sipeed/sipeed_keyboard/software/smk_manager/README.md

# WIP
1. OLED键帽显示和键盘宏
2. 支持切换风格
# 已完成
* 内置流水灯切换
* 视频播放模式
* 自定义流水灯
* 键盘状态显示
* 自动初始化
# 注意
首次使用会弹出认证页面，按照窗口指示操作就行。
