sipeed/sipeed_keyboard/assets/SMK68_2.png

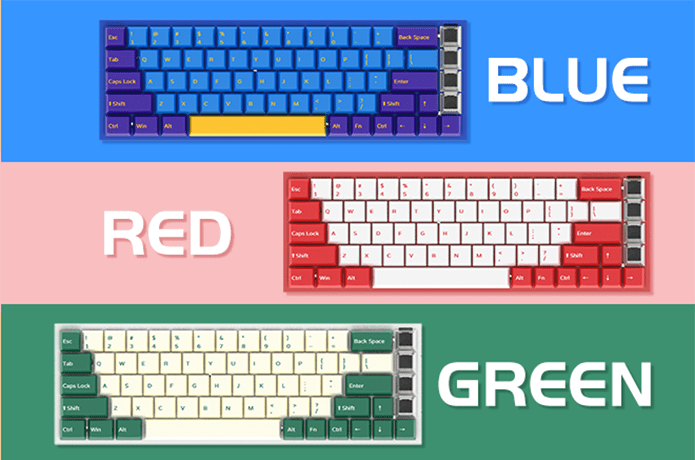
assets/SMK68_2.png
