sipeed/sipeed_keyboard/hardware/Sipeed_KeyBoard_SCH_5800.pdf

5

4

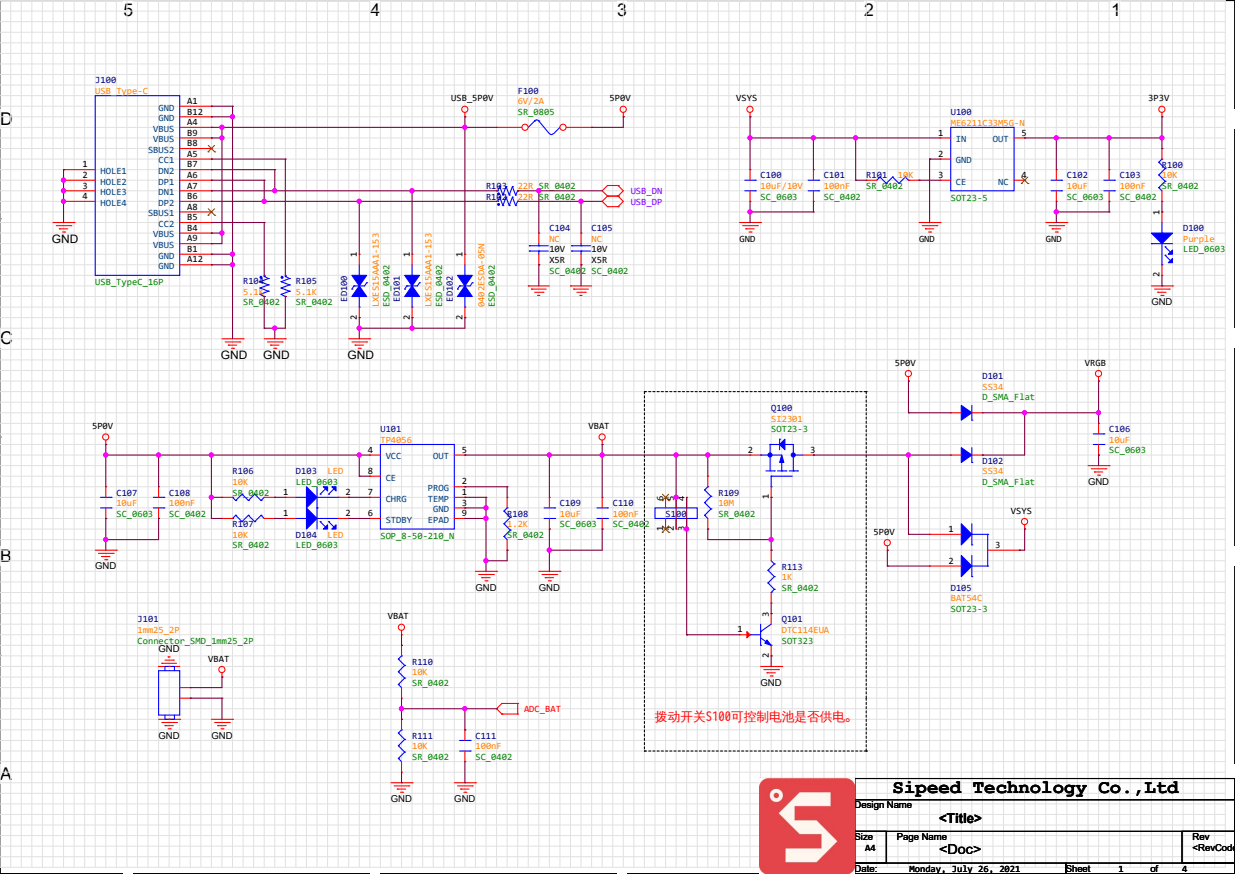
[picture p4: page 1]

J100 USB_Type-C
LXES15AAA1-153 ESD_0402 | SR_0402 ED101
SR_0402 ED102 | 0402ESDA-05N ESD_0402

GND | A1 | USB_5P0V | | | | | | 5P0V | | VSYS | | | | | | | | | | | | | | 3P3V
GND | B12 | | | SR_0805 | | | | | | | | | | | | | | U100 ME6211C33M5G-N
VBUS | | A4
VBUS | | B9 | | | | | | | | | | | | | | | | 1 | IN | OUT | 5
SBUS2 | | B8
CC1 | A5 | | | | | | | | | | | | | | | | 2

2 | HOLE2 | | DP1 | A6 | | | | | | | | | | | C100 10uF/10V | C101 100nF | R101 | 10K | | 3 | SOT23-5 GND CE | NC | 4 | | C102 10uF | C103 100nF
1 | HOLE1 | | DN2 | B7 | | | | | | | | | | | | | | | | | | | | | | | | | R100 10K

3 | HOLE3 | | DN1 | A7 | | R103 | 22R | SR_0402 | | | | USB_DN | | | | | SR_0402 | | | | | | | | | | | | SR_0402
4 | HOLE4 | | DP2 | B6 | | R102 | 22R | SR_0402 | | | | USB_DP | | | SC_0603 | SC_0402 | | | | | | | | | SC_0603 | SC_0402

SBUS1 | | A8
VBUS | | B4 | | | | | C104 NC | C105 NC | | | | | | | | | | | | | | | | | | | | LED_0603 ¹ 2 D100 Purple
CC2 | B5

GND | | | VBUS | | A9 | | | | | | | | | | | | | | | GND | | | | | GND

GND | A12 | | | | | SC_0402 X5R | SC_0402 X5R | | | | GND | | | | | | | | | | | | | | GND
GND | B1 | | | | | 10V | 10V

GND | GND | GND

5P0V | | VRGB

D_SMA_Flat

5P0V GND | | | R106 10K | D103 | LED | | 8

LED_0603 1 | | 2 | | | PROG | | 2 | | GND | | VBAT GND | | | | | | D_SMA_Flat | | GND

U101 TP4056 | | | | | | | | C106 10uF
4 | VCC | OUT | 5 | 2 3 | | | | | SC_0603

D102 SS34
SOT23-3 1 2

C107 10uF | C108 100nF | SR_0402 | | | | 7 | SOP_8-50-210_N CE CHRG | TEMP | | 1 | | | | | | | R109 10M

GND | 3 | | | C109 10uF | | C110 100nF

SC_0603 | SC_0402 | | | | | 6 | STDBY | EPAD | | 9 | R108 1.2K | | | | | S100 1 | | | | | VSYS

R107 10K | LED_0603 1 | | 2 | | | | | | | | SC_0603 | | SC_0402

D104 | LED | | | | | | | | | | | | | | 5P0V

SR_0402 | D105 BAT54C

J101 1mm25_2P | | | | | | Q101 DTC114EUA

SOT323 1

Connector_SMD_1mm25_2P
GND
VBAT GND | GND | SR_0402 | GND

ADC_BAT

拨动开关S100可控制电池是否供电。

Sipeed Sipeed Sipeed | | | | Technology Technology Technology | Co.,Ltd Co.,Ltd Co.,Ltd
Monday, July 26, 2021 | <Title> | | | 1 1 | 4 Design Name

Design Name

Size | | | Page Name | | | | | | | Rev
A4

D D

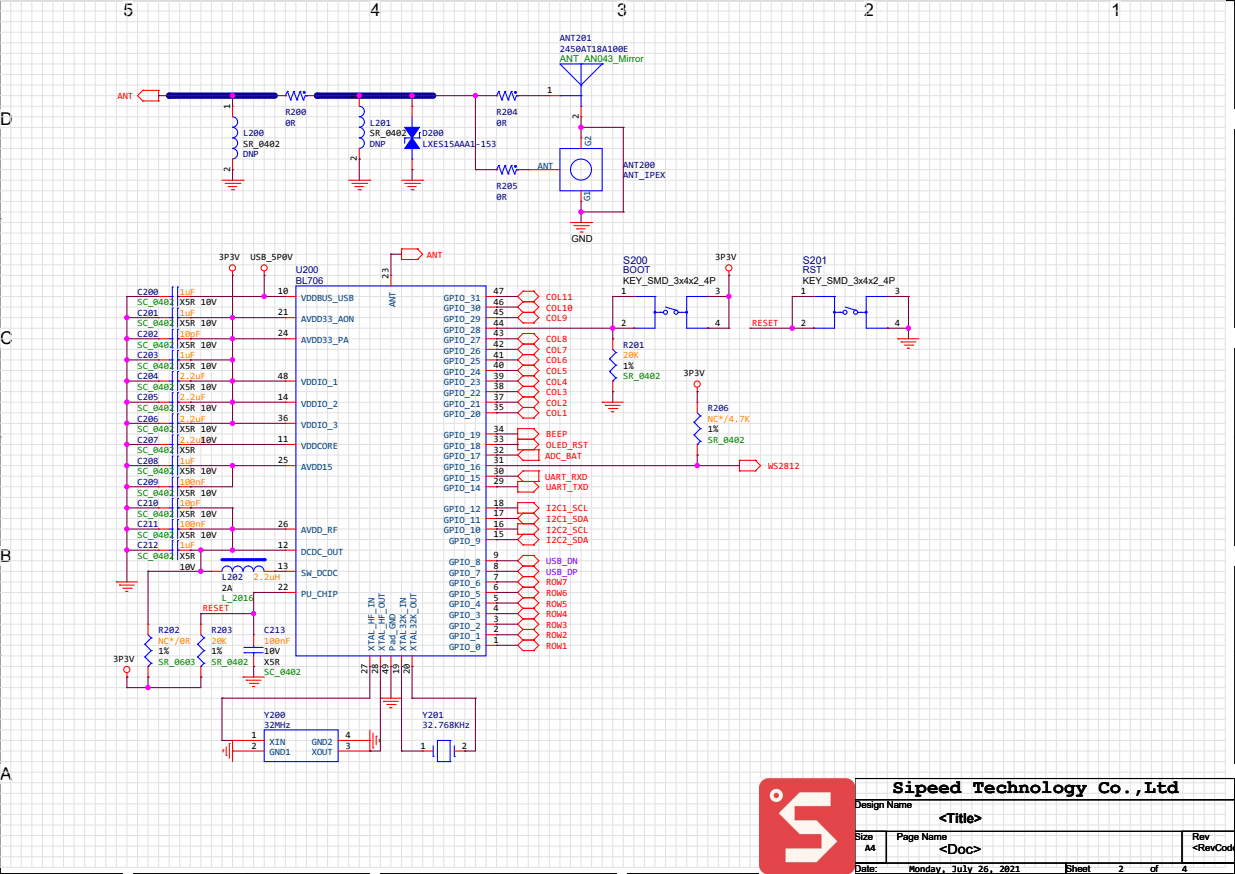
[picture p5: page 2]

2450AT18A100E ANT_AN043_Mirror 1

ANT

R200 | | | R204
0R | L201 | | 0R

L200 | | SR_0402 | D200
DNP | | | | | ANT | | G1 G2
SR_0402 | | DNP | LXES15AAA1-153

ANT200
ANT_IPEX

R205
0R

GND

3P3V | USB_5P0V | | | | | | | | S200 | | 3P3V | | | S201

C200 | | 1uF | | | | | | | | 24 ANT 23 10 | VDDBUS_USB | GPIO_31 | 47 | COL11 | 1 | | 3 | | | 1 | 3

U200 | | | | BOOT | | | | | RST
BL706 | | | | KEY_SMD_3x4x2_4P | | | | | KEY_SMD_3x4x2_4P

SC_0402 | | X5R | | 10V | | | | | | | | GPIO_30 | 46 | COL10
C201 | | 1uF | | | | | | | | | AVDD33_AON | GPIO_29 | 45 | COL9
SC_0402 | | X5R | | 10V | | | | | | | | GPIO_28 | 44 | | 2 | | 4 | RESET | | 2 | 4
C202 | | 10pF | | | | | | | | | AVDD33_PA | GPIO_27 | 43 | COL8
SC_0402 | | X5R | | 10V | | | | | | | | GPIO_26 | 42 | COL7 | R201
C203 | | 1uF | | | | | | | | | | GPIO_25 | 41 | COL6 | 20K
SC_0402 | | X5R | | 10V | | | | | | | | GPIO_24 | 40 | COL5 | 1%
C204 | | 2.2uF | | | | | | | | 48 | VDDIO_1 | GPIO_23 | 39 | COL4 | SR_0402 | 3P3V
SC_0402 | | X5R | | 10V | | | | | | | | GPIO_22 | 38 | COL3
C205 | | 2.2uF | | | | | | | | 14 | VDDIO_2 | GPIO_21 | 37 | COL2
SC_0402 | | X5R | | 10V | | | | | | | | | 35 | COL1 | | | R206
C206 | | 2.2uF | | | | | | | | 36 GPIO_20 | VDDIO_3 | | | | | | NC*/4.7K

SC_0402 | | X5R | | 10V | | | | | | 21 XTAL32K_OUT 20 XTAL32K_IN 19 | | GPIO_19 | 34 | BEEP | | | 1%

C207 | | 2.2uF | | 10V | | | | | | 11 | VDDCORE | GPIO_18 | 33 | OLED_RST | | | SR_0402
SC_0402 | | X5R | | | | | | | | | | GPIO_17 | 32 | ADC_BAT
C208 | | 1uF | | | | | | | | 25 | AVDD15 | GPIO_16 | 31 | | | | | | WS2812
SC_0402 | | X5R | | 10V | | | | | | | | GPIO_15 | 30 | UART_RXD
C212 | | 1uF | | | | | | | | 12 | DCDC_OUT | | 29 XTAL_HF_OUT 28 XTAL_HF_IN 27
C209 | | 100nF | | | | | | | | | | GPIO_14 | | UART_TXD
SC_0402 | | X5R | | 10V
C210 | | 10pF | | | | | | | | | | GPIO_12 | 18 | I2C1_SCL
SC_0402 | | X5R | | 10V | | | | | | | | GPIO_11 | 17 | I2C1_SDA
C211 | | 100nF | | | | | | | | 26 | AVDD_RF | GPIO_10 | 16 | I2C2_SCL
SC_0402 | | X5R | | 10V | | | | | | | | GPIO_9 | 15 | I2C2_SDA

SC_0402 | | X5R | | | | | | | | | | GPIO_8 | 9 | USB_DN

10V | | | | | | | 13 | SW_DCDC | GPIO_7 | 8 | USB_DP

L202 | | 2.2uH | | | | GPIO_6 | 7 | ROW7
2A | | | | 22 | PU_CHIP | GPIO_5 | 6 | ROW6
L_2016 | | | | | | GPIO_4 | 5 | ROW5
RESET | | | | | | | | GPIO_3 | 4 | ROW4

R202 | | | | R203 | | | | C213 | | | GPIO_1 | 1 Pad_GND 49 2 | ROW2

GPIO_2 | 3 | ROW3

NC*/0R | | | | 20K | | | | 100nF | | | GPIO_0 | | ROW1
1% | | | | 1% | | | | 10V

Y200 | | | Y201
32MHz | | | 32.768KHz
1 | XIN | GND2 | 4
2 | GND1 | XOUT | 3 | 1 2

D D

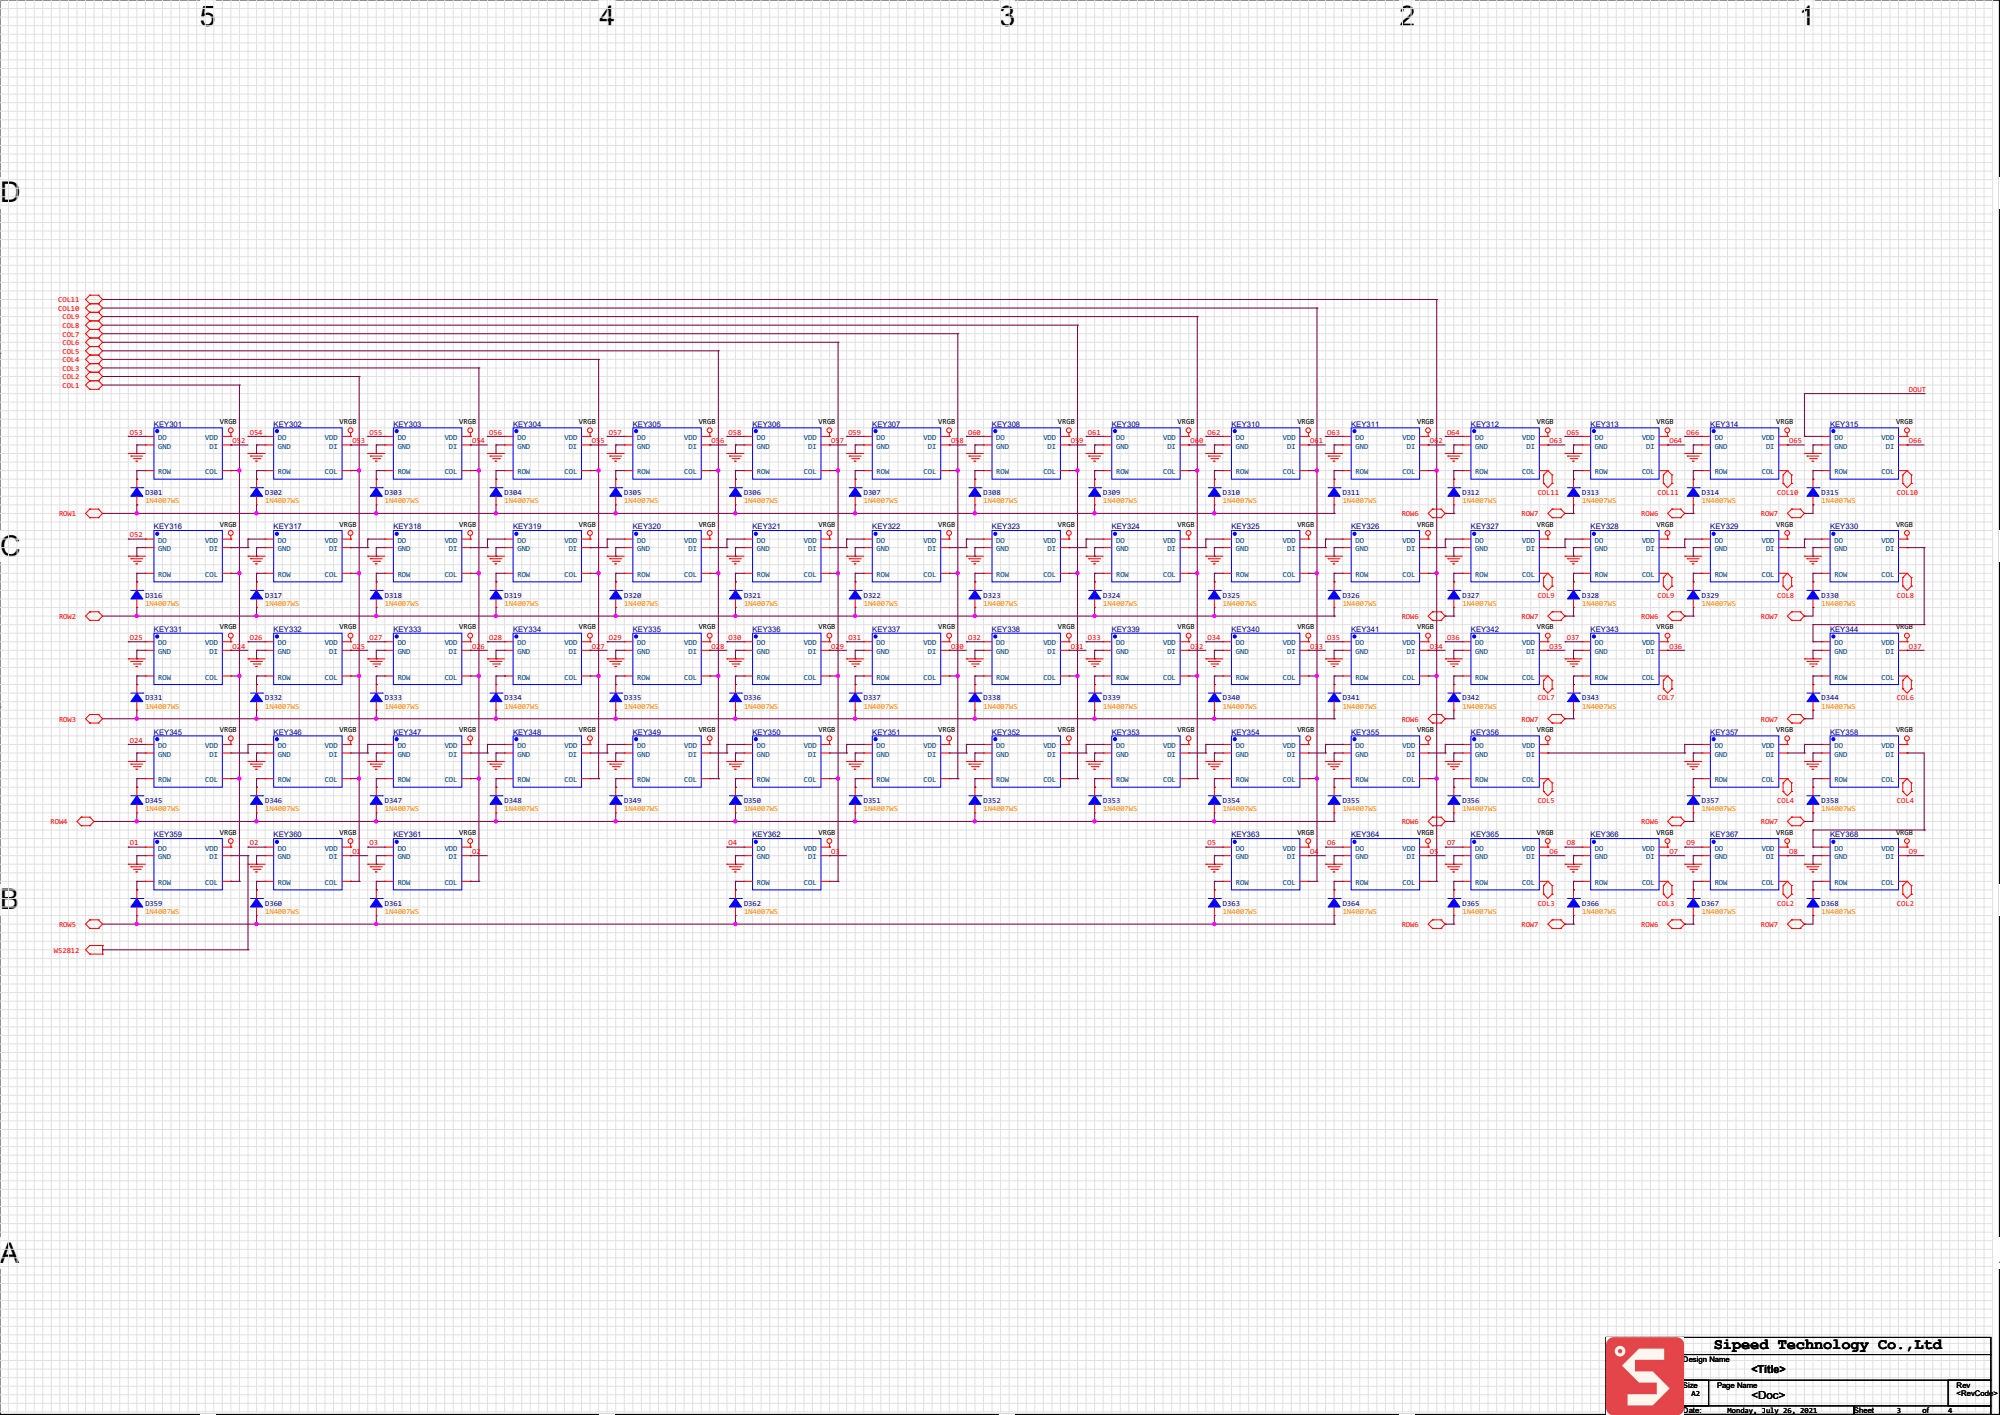
[picture p6: page 3]

D D

# 蜂鸣器

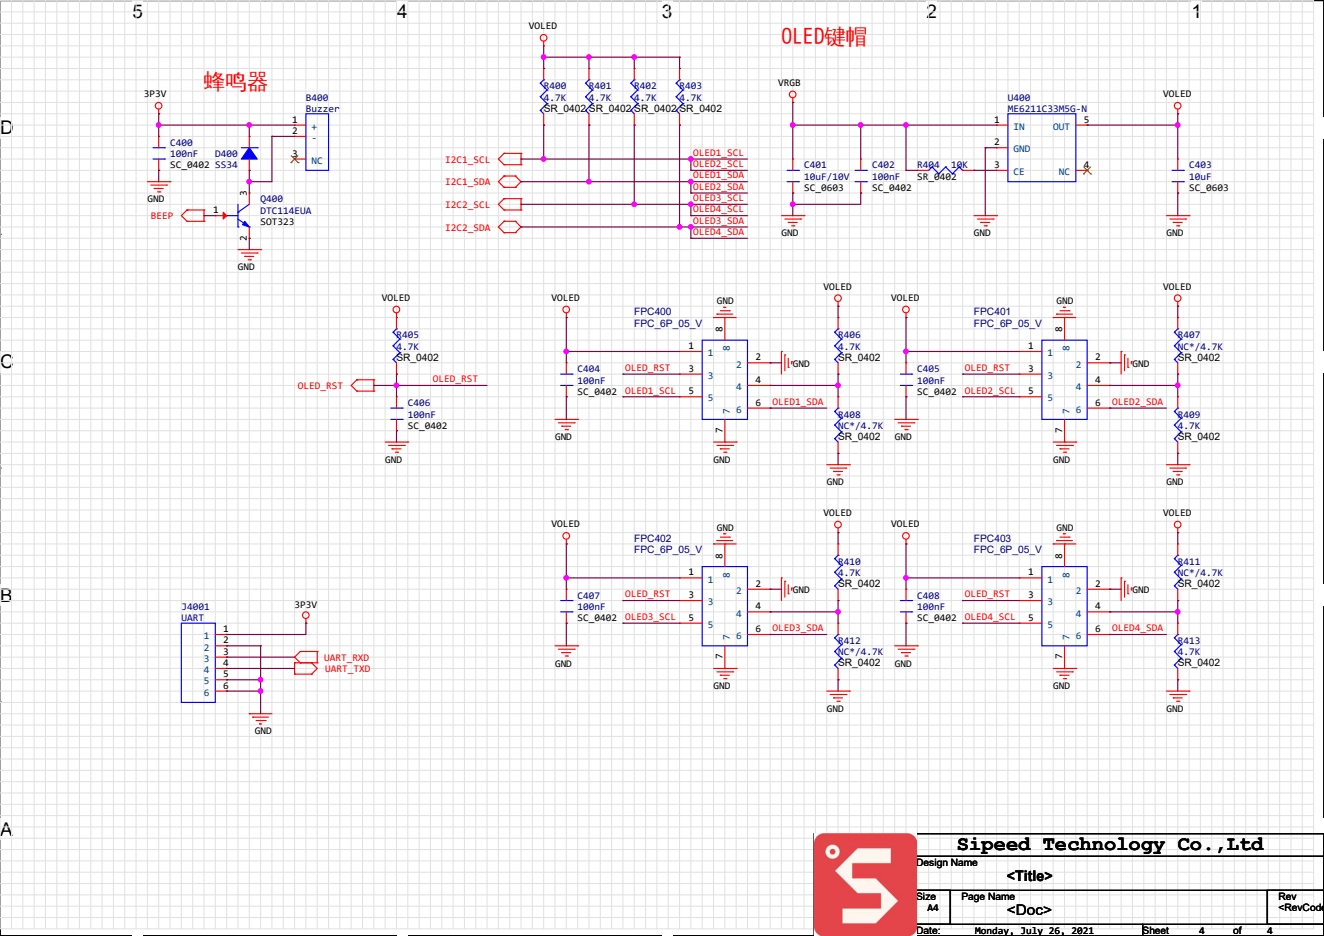
[picture p7: page 4]

OLED键帽 3P3V

R400 | R401 | R402 | R403 | | VRGB

B400 | | 4.7K SR_0402 | 4.7K SR_0402 | 4.7K SR_0402 | 4.7K SR_0402 | | | | | | | | | | U400 | | | VOLED
Buzzer | | | | | | | | | | | | | | | ME6211C33M5G-N
1 | + | | | | | | | | | | | | | | 1 | IN | OUT | 5

C400 | | | | | | | | | | | | | | | | | | 2 | GND
100nF | D400 | | 3 | NC | I2C1_SCL | | | | | OLED1_SCL
SC_0402 | SS34 | | | | | | | | | OLED2_SCL | | | C401 | C402 | R404 | 10K | | 3 | CE | NC | 4 | | | C403

I2C1_SDA | | | | | OLED1_SDA | | | 10uF/10V | 100nF | SR_0402 | | | | | | | | | 10uF

OLED2_SDA | | | SC_0603 | SC_0402 | | | | | | | | | | SC_0603

GND | | | Q400 | | | I2C2_SCL | | | | | OLED3_SCL
BEEP | | 1 | DTC114EUA | | | | | | | | OLED4_SCL

SOT323 | | | I2C2_SDA | | | | | OLED3_SDA

OLED4_SDA | | GND | | | | | GND | | | | | | GND

VOLED | | | | VOLED | | | | | | | | | | | | VOLED | | | | | | | | | | | | | | VOLED

GND | | | | | | | VOLED | | | | | | | GND

FPC400 | | | | | | | | | | | | | | FPC401
FPC_6P_05_V | | | | | | | | | | | | | | FPC_6P_05_V

R405 | | | | | | | | | | | | | | | | R406 | | | | | | | | | | | | | | R407
4.7K SR_0402 | | | | | | | | 1 | 1 | | | | | | | 4.7K SR_0402 | | | | | | 1 | 1 | | | | | | | NC*/4.7K

2 | 2 | | GND | | | | | | | | | | | 2 | 2 | | GND | | SR_0402

C404 | OLED_RST | | 3 | 3 | | | | | | | | | | C405 | OLED_RST | | 3 | 3

OLED_RST | | | | OLED_RST | | | 100nF | | | | | | 4 | 4 | | | | | | | 100nF | | | | | | 4 | 4

C406 | | | | | | | | | | 6 | 6 | OLED1_SDA | | | | | | | | | | | | 6 | 6 | OLED2_SDA
100nF | | | | | | | | | | | | | | | R408 | | | | | | | | | | | | | | R409
SC_0402 | | | | | | | | | | | | | | | NC*/4.7K | | | | | | | | | | | | | | 4.7K SR_0402

SC_0402 | OLED1_SCL | | 5 | 5 | | | | | | | | | | SC_0402 | OLED2_SCL | | 5 | 5

GND | | | | | | | | | | | | SR_0402 | | GND

VOLED | | | | | | | | | | | | | | VOLED

VOLED | | | | | | | GND | | | | | | | VOLED | | | | | | | GND

FPC402 | | | | | | | | | | | | | | FPC403

C407 | OLED_RST | | 3 | 3 | | | | | | | | | | C408 | OLED_RST | | 3 | 3

J4001 | | | 3P3V | | | | 100nF | | | | | | 4 | 4 | | | | | | | 100nF | | | | | | 4 | 4
UART | | | | | | | SC_0402 | OLED3_SCL | | 5 | 5 | | | | | | | | | | SC_0402 | OLED4_SCL | | 5 | 5
1 | 1 | | | | | | | | | | | 6 | 6 | OLED3_SDA | | | | | | | | | | | | 6 | 6 | OLED4_SDA
2 | 2 | | | | | | | | | | | | | | | | R412 | | | | | | | | | | | | | | R413
3 | 3 | | UART_RXD | | | | | | | | | | | | | | NC*/4.7K | | | | | | | | | | | | | | 4.7K SR_0402
4 | 4 | | UART_TXD | | GND | | | | | | | | | | | | SR_0402 | | GND
6 | 6 | | | | | | | | | | GND | | | | | | | | | | | | | | GND
