sipeed/sipeed_keyboard/firmware/keyboard/sipeed_keyboard_68/include/smk_oled_font8.h

//
// Created by hailin on 2022/3/6.
//

#ifndef SIPEED_KEYBOARD_SMK_OLED_FONT8_H
#define SIPEED_KEYBOARD_SMK_OLED_FONT8_H


const unsigned char  Font_code[][6] = {
        {0x00, 0x00, 0x00, 0x00, 0x00, 0x00},// (0)
        {0x00, 0x00, 0x4F, 0x00, 0x00, 0x00},//!(1)
        {0x00, 0x07, 0x00, 0x07, 0x00, 0x00},//"(2)
        {0x14, 0x7F, 0x14, 0x7F, 0x14, 0x00},//#(3)
        {0x24, 0x2A, 0x7F, 0x2A, 0x12, 0x00},//$(4)
        {0x23, 0x13, 0x08, 0x64, 0x62, 0x00},//%(5)
        {0x36, 0x49, 0x55, 0x22, 0x50, 0x00},//&(6)
        {0x00, 0x05, 0x03, 0x00, 0x00, 0x00},//'(7)
        {0x00, 0x1C, 0x22, 0x41, 0x00, 0x00},//((8)
        {0x00, 0x41, 0x22, 0x1C, 0x00, 0x00},//)(9)
        {0x14, 0x08, 0x3E, 0x08, 0x14, 0x00},//*(10)
        {0x08, 0x08, 0x3E, 0x08, 0x08, 0x00},//+(11)
        {0x00, 0xA0, 0x60, 0x00, 0x00, 0x00},//,(12)
        {0x08, 0x08, 0x08, 0x08, 0x08, 0x00},//-(13)
        {0x00, 0x60, 0x60, 0x00, 0x00, 0x00},//.(14)
        {0x20, 0x10, 0x08, 0x04, 0x02, 0x00},///(15)
        {0x3E, 0x51, 0x49, 0x45, 0x3E, 0x00},//0(16)
        {0x00, 0x42, 0x7F, 0x40, 0x00, 0x00},//1(17)
        {0x42, 0x61, 0x51, 0x49, 0x46, 0x00},//2(18)
        {0x21, 0x41, 0x45, 0x4B, 0x31, 0x00},//3(19)
        {0x18, 0x14, 0x12, 0x7F, 0x10, 0x00},//4(20)
        {0x27, 0x45, 0x45, 0x45, 0x39, 0x00},//5(21)
        {0x3C, 0x4A, 0x49, 0x49, 0x30, 0x00},//6(22)
        {0x01, 0x71, 0x09, 0x05, 0x03, 0x00},//7(23)
        {0x36, 0x49, 0x49, 0x49, 0x36, 0x00},//8(24)
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
        { 0x1F, 0x80, 0x20, 0x40, 0x20, 0x40, 0x20, 0x40, 0x30, 0x80, 0x00, 0x00 }, /*"C",35*/
        { 0x20, 0x40, 0x3F, 0xC0, 0x20, 0x40, 0x20, 0x40, 0x1F, 0x80, 0x00, 0x00 }, /*"D",36*/
        { 0x20, 0x40, 0x3F, 0xC0, 0x24, 0x40, 0x2E, 0x40, 0x30, 0xC0, 0x00, 0x00 }, /*"E",37*/
        { 0x20, 0x40, 0x3F, 0xC0, 0x24, 0x40, 0x2E, 0x00, 0x30, 0x00, 0x00, 0x00 }, /*"F",38*/
        { 0x0F, 0x00, 0x10, 0x80, 0x20, 0x40, 0x22, 0x40, 0x33, 0x80, 0x02, 0x00 }, /*"G",39*/
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
};
#endif //SIPEED_KEYBOARD_SMK_OLED_FONT8_H
