sipeed/sipeed_keyboard/(commit log)

2021-07-14 add sdk & sipeed_keyboard board
    [if_bflb_dbg.cfg, if_jlink.cfg, if_rv_dbg_plus.cfg, if_sipeed_dbg.cfg, image-loader.cfg, sifive-e2-ftdi.cfg, tgt_602.cfg, tgt_702.cfg]
2021-07-17 sync bl mcu sdk latest
    [if_rv_dbg_plus.cfg]
2021-08-20 Modify board config for SPI operation
2021-08-20 Add neopixel driver into smk project
2021-08-20 Add DMA support
2021-08-20 Add RGB LED debug command
2021-08-24 fix hid endpoint out add keyboard led set report callback add second hid interface for data transport enable usb debug output
    [smk_hid.c, smk_hid.h, smk_usb.c]
2021-08-25 add n-key rollover and mouse endpoint,auto switch when nkro interface got an set_idle (but actually it doesn't means host supports nkro as an mouse desc is right behind)
    [smk_hid.c, smk_hid.h, smk_spirgb.c, smk_usb.c]
2021-08-27 增加读写回执的确认
2021-08-28 remove old sdk
    [if_bflb_dbg.cfg, if_jlink.cfg, if_rv_dbg_plus.cfg, if_sipeed_dbg.cfg, image-loader.cfg, sifive-e2-ftdi.cfg, tgt_602.cfg, tgt_702.cfg]
2021-08-29 style: use camel case naming conventions for keycode
2021-08-31 feat: add eager_defer_pk algorithm for keyscan debouncing
    The eager_defer_pk means that debouncing per key, and eager for key-
    down, defer for key-up. This algorithm can be used for faster typing,
    which has the fastest response time, however more resource are required,
    and not stable enough for some mechanical switches.
2021-08-31 add cap led change debug flag to work with cmake add custom keymap support(for now only work on build) uncomment ble header to avoid one warning
    [main.c, sipeed_mechanical_keyboard.c, smk_hid.c, smk_hid.h, smk_keymap.h, smk_keyscan.h, smk_spirgb.c]
2021-08-31 add gamma calibration on keyboard side update gui and api
2021-09-01 修正了macOS上的全键无冲自动切换 *必须同时把cmake构建类型改成DEBUG开启调试输出不然在macOS上会出一些奇奇怪怪的问题
2021-09-26 添加键盘控制软件界面
2021-09-29 修改了qss
2022-01-06 Fix crashing due to unwanted interrupt nesting
    [smk_hid.c]
2022-01-07 fix caps led bug
    [smk_battery.c, smk_spirgb.c, smk_usb.c]
2022-02-27 fix rgb use dma macro
    [smk_spirgb.c, smk_spirgb.h]
2022-02-27 modify keycode short name
    [sipeed_mechanical_keyboard.c, smk_keycode.h]
2022-02-28 fix hog notify conn ref
    [smk_ble.c]
2022-03-04 Add usb and ble switch key.
2022-03-05 Add ble muti dev switch
2022-03-06 Add OLED Driver and basic oled API
2022-04-19 更新SMK软件
2022-04-19 修复初始化
2022-04-20 按照要求修改
